toyoshim/iona/(threads)

Thread 1 (2019-07-02):

[Example] iona compatibility

toyoshim, 2019-07-02:
It worked with naomi - Ikaruga.

toyoshim, 2019-07-02:
If working titles are reported like this, I will update the Wiki's Compatibility Information.
https://github.com/toyoshim/iona/wiki/Compatibility-Information

If something is wrong, I will try getting the PCB and supporting it.

toyoshim, 2019-07-02:
Example for Japanese
日本語でもOK

naomi - 斑鳩 動作 - 動作

などと報告があれば、Wikiの情報を更新します。
動作しない報告も歓迎。基板を入手でき次第、対応を試みます。

hnakai0909, 2019-07-03:
System12 - Paca Paca Passion (PPP1) - 動作
System12 - Paca Paca Passion Special (PSP1) - 動作

なお, jvsioサブモジュール部分については,
独自のProMicro向け[移植](https://github.com/toyoshim/jvsio/pull/1/commits/ff60f7e06fa0ab4b34fd992d0e49b8fec4afaa13)を適用したものによる動作報告です.

toyoshim, 2019-07-03:
English:
Reflect https://github.com/toyoshim/iona/issues/1#issuecomment-507971420 to [Compatibility Information](https://github.com/toyoshim/iona/wiki/Compatibility-Information)

It's fine to append new report here, or you can file a separate issue so that I can close it after reflecting the report.

Japanese:
https://github.com/toyoshim/iona/issues/1#issuecomment-507971420 を[Compatibility Information](https://github.com/toyoshim/iona/wiki/Compatibility-Information)に反映させました。

ここに書いてもらっても良いし、別途issueを立ててもらってもOKです。別issueの場合は反映させたらcloseでお知らせします。

cyllboy, 2020-08-08:
Naomi 2 - Virtua Tennis (Power Smash) works flawless.

toyoshim, 2020-08-08:
Thanks! Now the Virtua Tennis is in the list!

cyllboy, 2020-08-16:
Naomi 2/Atomis wave patched - Fists of the North Star. SW Standard.
Naomi2 - Capcom_vs_SNK_Millenium_Fight_2000_Pro. SW Standard - (only 4 buttons?)

toyoshim, 2020-08-16:
Added.
I changed the system board for Virtua Tennis and new two to "naomi" rather than "naomi2" as these titles work on naomi1 too.

Regarding the 2000 pro, it seems to use only 4 buttons if [information at wikipedia](https://ja.wikipedia.org/wiki/%E3%82%AB%E3%83%97%E3%82%B3%E3%83%B3_%E3%83%90%E3%83%BC%E3%82%B5%E3%82%B9_%E3%82%A8%E3%82%B9%E3%83%BB%E3%82%A8%E3%83%8C%E3%83%BB%E3%82%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) is correct.

cyllboy, 2020-08-16:
Very good! Thank you! They are Naomi native, apart from Fists of North Star that is patched for Naomi (Atomis Wave native)

cyllboy, 2020-08-16:
Naomi - Kuru Kuru chameleon. SW Standard.
Naomi - Mobile Suit Gundam - Federation Vs Zeon. SW Standard.
Naomi - Project Justice - Rival School 2. SW Standard.
Naomi 2 - Beach Spikers. SW Standard.

toyoshim, 2020-08-25:
Information above should be seen in the compatibility page now.
Thanks a lot!

cyllboy, 2020-08-25:
> Information above should be seen in the compatibility page now.
> Thanks a lot!

It's a pleasure!

Thread 2 (2019-07-17):

Coin credits decrease at 30 credits/sec on using it with TAITO Type X2

toyoshim, 2019-07-17:
When I use iona with TAITO Type X2, coin counter continues to decrease at 30 credits/sec speed.
Probably something is wrong on command 0x30 or 0x35.

Other functionalities work well.

toyoshim, 2019-07-21:
Coin unit number should start with 1 rather than 0.
This bug results in that X2 continues to ask decreasing the credit count at every frame, since X2 manages JVS's credit to be always 0.

Closed 2019-07-21.

Thread 4 (2019-10-22):

two player

itslemcy, 2019-10-22:
hi, great work first of all.
i was wondering if it is possible with an arduino with a lot of gpios such as the mega2650, to have a two player input.
thanks a lot!

toyoshim, 2020-08-08:
sorry for the late answer.
yep, the sample code includes mega2560 support and I think it works with 2P support though I haven't verified on the real board yet.
just fyi, the underlying library, jvsio now supports multiple nodes within a single microcontroller. that says now it's possible to support 2 nodes x 2 players = 4 players in total if gpio allows. of course, 1 node x 4 players configuration would be possible.

Closed 2020-08-08.

Thread 5 (2020-06-29):

ringedge support

mikebrandt, 2020-06-29:
HI,thanks for this great project! I made myself a board using a nano and it doesn't seem to be recognized by ringedge system. I did trick the id as i know ringedge is only type 3 IO compatible but it doesn't seem to do the job. Is the actual code missing something for type 3 IO operations?

Best Regards,
Mike

toyoshim, 2020-06-29:
As far as I tried, it works with the most titles for RE2.
So, I believe iona should be compatible with RE1 in essential parts, and it will work with small mods.

IIRC, Sega 837-14572 is the type 3 IO board, right?

According to this wiki site,
https://wiki.arcadeotaku.com/w/JVS
It has 14 input buttons per player.

So, I guess the IONA should return 0x0D instead of 0x0C at the line 190.
https://github.com/toyoshim/iona/blob/master/iona.ino#L190

JVS titles check several JVS IO information.
# of players, # of digital buttons, and the board name are such things I confirmed until today.

mikebrandt, 2020-06-29:
thanks for your reply.  I tried to trick id with "SEGA CORPORATION;I/O BD JVS;837-14572;Ver1.00;2005/10" but it dosen't seem to work either. Maybe there's something wrong with my wiring , i didn't wired your dipswitchs ios, only data + data - ground and sense using the low filter RC trick.
data+: RX0
data-: D2
Sense: D3 via RC filter

Best regards,

toyoshim, 2020-06-29:
Hum... can you enter the RE's test mode and confirm if the iona is recognized as a JVS node?

If iona is not recognized:
Can you modify jvsio/JVSIO.cpp so that dump() do nothing? This is used to output debug messages, but it may result in timing violation on JVS transaction. Ringedge and Ringwide seem timing sensitive.

If iona is recognized:
Can you try with line 190 fix only? IONA's default name passes all known cases until today as starting with "SEGA ENTERPRISES,LTD." seems to be the key portion for some titles running on SEGA hardwares. Exact match with the original type 3 board may result in more strict information checks. Not sure, but just in case.

Also, if you don't use DIP switch, please pull-down A7, or remove DIPSW handling code from updateMode() in iona.ino. You should keep the suchipai_mode and virtual_mode to be false for usual uses.

mikebrandt, 2020-06-30:
thanks for your reply. I Applied all your recommendations at once and it works, so many thanks for this. Now i will revert it back step by step to see what was the original problem then i'll move on arduino mega tests. Is there a way to make a donation for your work on this?
Best regards

toyoshim, 2020-08-08:
thanks!
no worries, feedback is already beneficial contributions to this project!

toyoshim, 2020-08-08:
If you can provide, information for the compatibility list below can be another great contribution :)
https://github.com/toyoshim/iona/wiki/Compatibility-Information

Thread 6 (2020-07-30):

Earth of the RC-LPF

cyllboy, 2020-07-30:
I know... this is a newbie question...
Where do I connect the earth of the RC-LPF? As far as I know it is not the same as "ground".

I refer to the symbol:

   |
-----
/////

Thank you!

cyllboy, 2020-08-07:
Issue solved, I Connected it to the common ground

toyoshim, 2020-08-08:
Sorry, I haven't noticed your question.
Yes, using a common ground is fine. RC-LPF is a "kind of analog circuit", but here it is used only to generate a 2.5V signal from a 5V 1:1 PWM signal. So, we don't need to be so serious against noise.

toyoshim, 2020-08-08:
this will be a good question to be kept open for others.

cyllboy, 2020-08-08:
Thank you! Your design works like a charm!

Thread 7 (2020-08-14):

Only two buttons working

cyllboy, 2020-08-14:
I'm testing with a Naomi 2 board, I have only two buttons working. Up down left right, player 1 start and player 1 coin are ok. Only fire buttons A and B work. Checked twice the connections but are a ok and tested with multimeter.

I'm pulling down A7 with 10K ohm resistor to simulate dip switch off.

Do you have any suggestions?

toyoshim, 2020-08-14:
oops!
sorry, it seems my last commit mistakenly added a bug.

> 221:          io.pushReport(index < sizeof(index) ? ios[index] : 0x00);

This line should be

> 221:          io.pushReport(index < sizeof(ios) ? ios[index] : 0x00);

I will submit a fix soon.

toyoshim, 2020-08-14:
submitted!
can you try with the the latest revision?

sorry for bothering you.

cyllboy, 2020-08-15:
The latest version works very well! Now all the 6 buttons are ok!
Thank you very much!

toyoshim, 2020-08-15:
Good to hear that my fix works, and thanks again for letting me know this issue.

Regarding the compiler warnings, I guess you are using a little old Arduino IDE.
With my 1.8.12 on mac, iona compiles without any warning. Maybe due to no or poor C++11 support in early Arduino IDE?

cyllboy, 2020-08-16:
I had 1.8.12 but I'm using windows; now I updated to 1.8.13, but  warnigs did not go away.

At first installation, the warnings are covered by the code windows... and I didn't see them in windows because the lasting message was the OK thing: "Lo sketch usa 5306 byte (17%) dello spazio disponibile per i programmi. Il massimo è 30720 byte.
Le variabili globali usano 1030 byte (50%) di memoria dinamica, lasciando altri 1018 byte liberi per le variabili locali. Il massimo è 2048 byte." (My installation is Italian)

Did you tried to enlarge the debug portion of the window?

Here is what I see: https://www.cyllenius.net/Screenshot%202020-08-16%2009.53.03.png

Then I opened better the window and I could see that the warnings were still there. They are these:
"
H:\Desktop\iona\iona.ino: In function 'setup':
H:\Desktop\iona\iona.ino:142:19: warning: iteration 15 invokes undefined behavior [-Waggressive-loop-optimizations]
     pinMode(pins[i], INPUT_PULLUP);
             ~~~~~~^
H:\Desktop\iona\iona.ino:141:21: note: within this loop
   for (int i = 0; i < sizeof(pins); ++i)
                   ~~^~~~~~~~~
C:\Program Files (x86)\Arduino\hardware\arduino\avr\cores\arduino\main.cpp: In function 'main':
H:\Desktop\iona\iona.ino:142:19: warning: iteration 15 invokes undefined behavior [-Waggressive-loop-optimizations]
     pinMode(pins[i], INPUT_PULLUP);
                   ^
H:\Desktop\iona\iona.ino:141:21: note: within this loop
   for (int i = 0; i < sizeof(pins); ++i)
"

I don't know if this is a problem with my current computer where I installed in the time various versions of the IDE... I will try on a fresh computer that never had Arduino IDE on and I will report better.

cyllboy, 2020-08-16:
I confirm the same behaviour on a fresh laptop... The warings are generated, than they "roll out of sight" during compilation.

Probably the C++ support is very weak in windows version.

The warnigs go away if the loop is not used, but so the code should be taylored on the number of pin used on the specific device, leaving less freedom. What do you think?

toyoshim, 2020-08-16:
oops, compiler is correct. there is a buffer-overflow bug.
the loop should be "i < sizeof(pins) / sizeof(int)".

I'm on mac. probably installed AVR compiler version is different among Windows and mac.

I'll update it.

toyoshim, 2020-08-16:
done!

cyllboy, 2020-08-16:
Y*O*U* A*R*E* G*R*E*A*T*!!!!!!!!!!!!!!!!!!!!!!! =b

Closed 2020-08-15.

Thread 10 (2020-11-14):

About MegaClient Sense port

xxjerryxx1983, 2020-11-14:
FIrst of all, thank you for bring us such nice program, I really appreciate it.
I'm wondering if that the JVS sense port in ArduinoMega client is correct, because the OC2B port on board is D9, not D3 port mentioned in file, and neither 2 ports are not effective for the game.
The "JVS connect error" will happen when I enter the TTX game(SF4 AE, KOF98Um), please tell me the correct port of the sense signal, thank you very much.

// Data+: 2 PD2 ( RXDI/INT2 )
// Data-: 3 PD3 ( TXD1/INT3 )
using MegaDataClient = BaseDataClient<0, 1, 0, 1, 0x0e, 0x0e>;

// Sense: 3 (PWM OC2B - RC LPF of 100nF, 100Ω is needed to generate 2.5V)
using MegaSenseClient = BaseSenseClient<3>;
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

toyoshim, 2020-12-09:
Thank you for your report, and sorry for the late reply.

> I'm wondering if that the JVS sense port in ArduinoMega client is correct, because the OC2B port on board is D9, not D3 port mentioned in file, and neither 2 ports are not effective for the game.

> // Sense: 3 (PWM OC2B - RC LPF of 100nF, 100Ω is needed to generate 2.5V)
> using MegaSenseClient = BaseSenseClient<3>;

You are right. It's a bug. We should use D9 for the SENSE port. So, the using line should be BaseSenseClient<9>;.
Also, the D9 is used for 1P button2 by default in the IONA. So, we need to replace it with another available pin.

I will submit a speculative fix for this though I'm not ready for testing this on mega2560.

toyoshim, 2020-12-09:
Can you check the latest revision?
I fixed the jvsio library to use pin9 for sense on mega.
Also, pin assignment for the mega is changed in iona.ino.

Closed 2020-12-09.

Thread 12 (2021-02-15):

Service button

kimaq, 2021-02-15:
Hi,

I'm testing your project on Arduino Nano. It's working great but as I can see for this board there's no Service button handling.
I'll switch to Mega if needed but is it possible to do it on Nano?

  //       START       SERVICE     UP          DOWN        LEFT        RIGHT       PUSH1       PUSH2
    ios[1] = in( 2, 7)    ???    | in( 3, 5) | in( 4, 4) | in( 5, 3) | in( 6, 2) | in( 7, 1) | in( 8, 0);

Kind Regards,
Peter

toyoshim, 2021-02-27:
Well, A4 and A5 are still free on the nano.
So, you can put one of them into pins[] array, and use the IO for the service button.

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

'in(13, 6)' should be inserted for ios[1]. '13' means the A4 is placed at 13th (0 origin) in the pins. '6' means service button here.

> ios[1] = in( 2, 7) | in(13, 6) | in( 3, 5) | in( 4, 4) | in( 5, 3) | in( 6, 2) | in( 7, 1) | in( 8, 0);

I haven't verified these code, but probably it works.

kimaq, 2021-02-27:
Thanks,
It's working now. But now as I can access input test mode I noticed that some inputs are triggering another inputs.
For example holding SW1 I get solid "ON" on JVS test screen.
But holding SW3 I get constantly ON/OFF for SW3 and for SW2 as well. It's the same for most other inputs.
Do you know what can be wrong? I've checked the wiring and it looks good. My nano is a clone, maybe that is a problem?

toyoshim, 2021-02-28:
Did you edit following lines correctly?
> //#define USE_NANO
> #define USE_MEGA

Default code isn't for Nano, but for MEGA2560.

Also, can you check if the unstable input issue disappears when you remove updateMode() call at line 166?

kimaq, 2021-02-28:
Thanks again,

removing updateMode() solved the issue:) I can finally play my Naomi outside the cabinet.

Closed 2021-02-28.

Thread 13 (2021-11-13):

missing push button 2 for two player mode on Mega

mikebrandt, 2021-11-13:
Hi,
 i tried to compile iona for Mega and i think that push button 2 for player 2 is missing in io def at line 117. Am i reading code wrong?

Best regards,
Mike

toyoshim, 2021-11-14:
I guess you meant line 177.
This is just a source formatting issue. The service button isn't assigned for the player 2 (as same as player 1), and it results in that we have just 7 `in(n, m)` in the line. So, that should be fine.
I will submit a format fix change.

toyoshim, 2021-11-14:
https://github.com/toyoshim/iona/commit/65986f8bb2548e6de19828708844f9878198d156
Hope this CL explains better than my words above.

Closed 2021-11-14.

Thread 14 (2021-11-14):

Missconfiguration on Mega Client definition?

mikebrandt, 2021-11-14:
Hi,
   tried to make iona work for Mega 2560 and i think there's a missconfiguration on MegaClient:
// Data+: 2 PD2 ( RXDI/INT2 )
// Data-: 3 PD3 ( TXD1/INT3 )
using MegaDataClient = BaseDataClient<0, 1, 0, 1, 0x0e, 0x0e>;

In that setting , Data + seems to be assigned to PD0 and Data - to PD1.
Am I reading it wrong?

Best regards,
 Mike

toyoshim, 2021-11-14:
Thank you for your feedback.
I actually provided the Mega Client, but I haven't gotten a chance to verify my code with a device.
So, there would be some bugs.

Regarding the MegaDataClient, I think the comment was wrong.
Maybe I copied it from another port, and just forgot to modify the comment.
Let me have a fix.

toyoshim, 2021-11-14:
Can you try the latest version?
Now the comment was fixed. We use D0/D1 (== PE0/PE1 or RX0/TX0) for Data+/Data-.
Also, I notice that P2 button 5 and 6 were mistakenly assigned to non-existing GPIO pins.
So, I changed it to use D2 and D3.

Please let me know if something is still wrong.
Thanks!

mikebrandt, 2021-11-15:
Hi,
 just tried it with last version , wired data + on D0 and data - on D1 (sense still on D9). No input is sent to the mobo (TTX3) while it works great with nano version. Are you sure about register adress on Mega Client?  those values shouldn't be different between nano and Mega . From what i understand, it should be 0x0b according to documentation.
Best regards,
Mike

mikebrandt, 2021-11-18:
Hi, i think you're right:
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
so problem must be elsewhere, i'll try to serial debug it to see what's going on.

Thread 15 (2021-12-10):

NanoSenseClientSupportingDaisyChain broken?

mikebrandt, 2021-12-10:
Hi,
 i tried to link 2 nano to enable multiple nodes . I replaced NanoSenseClient  NanoSenseClientSupportingDaisyChain in main code this way:
`#if defined(USE_NANO)
NanoDataClient data;
NanoSenseClientSupportingDaisyChain sense; //using daisyChain sense client
//NanoSenseClient sense; //original
NanoLedClient led;`

when compiling it comes with this error:
`In file included from C:\ionav2\iona\jvsio\clients\NanoClient.h:12:0,
                 from C:\ionav2\iona\iona.ino:10:
C:\ionav2\iona\jvsio\clients\BaseClient.h: In instantiation of 'void BaseSenseClientSupportingDaisyChain<PORT, TCCRA_VAL, TCCRA_FLIP, OCRA_VAL, SENSE>::begin() [with int PORT = 3; int TCCRA_VAL = 18; int TCCRA_FLIP = 16; int OCRA_VAL = 1; int SENSE = 19]':
C:\arduino_projects\iona\iona.ino:271:1:   required from here
C:\arduino_projects\iona\jvsio\clients\BaseClient.h:144:66: error: 'void BaseSenseClient<PORT, TCCRA_VAL, TCCRA_FLIP, OCRA_VAL>::begin() [with int PORT = 3; int TCCRA_VAL = 18; int TCCRA_FLIP = 16; int OCRA_VAL = 1]' is private within this context
     BaseSenseClient<PORT, TCCRA_VAL, TCCRA_FLIP, OCRA_VAL>::begin();
     ~~~~~~~~~~~~~~~~~~~~~~~~~~~~~~~~~~~~~~~~~~~~~~~~~~~~~~~~~~~~~^~
C:\arduino_projects\iona\jvsio\clients\BaseClient.h:114:8: note: declared private here
   void begin() override {
        ^~~~~
exit status 1
`

Am I doing it wrong or is the code broken?

Best regards,
Mike

mikebrandt, 2021-12-16:
Ok, found what was broken since begin method was declared private into BaseSenseClient , it couldn't be used by DaisyChain client,  changed it t protected solved the problem.
`template <int PORT, int TCCRA_VAL, int TCCRA_FLIP, int OCRA_VAL>
class BaseSenseClient : public JVSIO::SenseClient {
 protected: //former private
  void begin() override {`

Now i need to test node linking. I'll keep you updated with this!

mikebrandt, 2021-12-17:
Just did some tests with two board linked on TTX3. First board in the chain isn't recognized and second is seen as 1 player but controls work . Any idea on how this could happen? Or any adivse on how to test nodes?
Best regards,

Thread 16 (2022-05-05):

Naomi detection issues

system11b, 2022-05-05:
I have a V2 Iona which was only recently purchased and I believe has 1.3x firmware installed.  It works with Ringedge2 and Exa systems, but my Naomi 1 doesn't recognise it - the blue LED never stops flashing, test mode cannot see any JVS nodes, and starting a game gives JVS IO not connected errors.  I have tried multiple USB(JVS) and power cables right down to the shortest available - these did not make a difference.  The Naomi works fine with Capcom and Sega JAMMA-JVS converters so I assume it is working correctly.

There are a few people with the same issue on the arcade projects forum:
https://www.arcade-projects.com/threads/mp07-iona-us-jvs-usb-i-o-board-worldwide-sales-troubleshooting-thread.20112/page-11

system11b, 2022-05-05:
I solved the problem, kind of.

I had to upgrade the firmware from 1.35 to 1.42d, even after upgrade it was not detected until I used the new options mode to inactivate the JVS signal adjustment.  I have a question - what does this option actually do?  Will it potentially cause harm to other hardware (for example my Exa) by sending a high signal, or is it the other way around and disabling a boost?  I repeated the test several times, with the signal adjustment enabled (default dip 3) it always fails, with dip 3 on to disable adjustment it is reliable both in BIOS and Game modes.

I also had a problem with WinUSB and getting "This device cannot start. (Code 10)" when trying to install the WinUSB driver.
I did a bunch of testing, it's simply not compatible with some USB ports. It doesn't work on the built in USB-A (3.1) ports on my Lenovo X1 gen 4, but it's fine with a couple of cheap unpowered USB-C hubs/adapters - for example the Unigreen USB-C to Ethernet dongle which has 3x USB-A (3.1) ports. That works perfectly.

mobiusstriptech, 2022-05-20:
Same issue here. Worked just fine on both my NAOMI 2 but neither of my NAOMI 1 would work with the device. I ended up doing the same thing you did and upgrading the firmware, then disabling the JVS signal adjustment. For those with Xbox controllers button 3 is B, just to help you figure that out.

I wish there was an easier way to disable/enable this. Figuring out how to get to the options menu is tricky. Once I figured out that I had to hold test and service for .5 seconds, then press service, then press test 2 times, then hold down B on my controller when pressing test again for the 3rd time, it worked great. Hope that explanation helps others.

Could we have this option disabled by default? Or maybe hold test on power on to enable/disable?

toyoshim, 2022-05-22:
Hi, this is a repository for an Adruino-based IONA, and what you are talking about is IONA-US, and the repository is https://github.com/toyoshim/iona-us/issues

toyoshim, 2022-05-22:
Reg the signal adjustment option, it doesn't affect sending signals, but affects receiving ones as some device's neg signal is really higher, e.g. 1.7V, than the threshold for the 3.3V based IONA's microcontroller. So this is an option to activate voltage divider for receiving signals.

This compatibility troubles happen because IONA-US could not cover all possible valid range of EIA-RS485 but signal's characteristics vary board by board.

toyoshim, 2022-05-22:
Also, the signal compatibility issue is explained in the official document at the compatibility section.
https://toyoshim.github.io/iona-us/en

Your experience around WinUSB's trouble shooting would be helpful for other users. I'll update the page with your information.

toyoshim, 2022-05-22:
To mobiusstriptech:
Having another easy option to flip the mode sounds a good idea. But I don't want to change the default mode as more devices are compatible with this flag being enabled.

toyoshim, 2022-05-23:
Let me close this thread as this issue doesn't happen on Arduino based IONA as AVR runs at 5V.
Feel free to open new issue for iona-us.

toyoshim, 2022-05-28:
@mobiusstriptech please check the latest firmware as it contains the feature you requested, booting with TEST pressed will flip the signal adjust option.

mobiusstriptech, 2022-05-28:
Loaded the new firmware and tested using Test button to flip the JVS signal off and on. It works great! Excellent addition to the firmware!
