toyoshim/iona/(commit log)

2018-02-11 Update README.md
    Fix broken layout of schematic.
2018-02-21 coint counter bug fix
    [iona.ino]
2018-02-22 Su Chi Pai III mode
    Maybe Naomi's common protocol to support mahjong controllers.
    JVS 3 defines an input swith layout for mahjong games, but
    Su Chi Pai use a different protocol, probably because the spec
    hasn't defined yet when the game is launched.
    It uses general purpose output driver to select a input switches
    set to multiplex input switches in the first line .
2018-03-09 Support more naomi games
    To support more naomi games,
    - Use SEGA compatible names for the board ID
    - Change capability to say supporting two players (just saying)
    - Ditto, supporting analog inputs
2018-09-04 Add Virtual-On mode
    Implement Virtual-On mode that emulates the twin stick controller
    by single arcade controller that has only one 1 stick and 4 buttons.
    The arcade stick affects both left and right sticks, but if button 2
    is pressed, right results in turning left, left does turning right,
    up does jumping, and down does cancelling it. Button 1 is L shot,
    button 4 is R shot, and button 3 is turbo for both L and R.
    Not sure if this is the best assignments, but it works enough.
    Suggestion is welcomed, but definitely using SS twin stick is the
    best alternative way to play Virtual-On.
2018-11-21 Update README.md
    5V from JAMMA should be provided via Nano 5V pin.
    VIN needs 7+V for driving regulator to generate expected 5V.
    Probably, JAMMA's 12V may work with VIN, but I haven't tried.
2019-06-09 Bug fix
    - Roll the latest jvsio that fixed bugs
    - Update .ino so to follow the new interface
    Following revisions after recent JVSIO rools haven't worked.
    - 79592a636e6a663a153fc996fef43db999d215f2
    - 228c5826017673b9b91f06f56172fd73c64edcdd
    - 4b75ca0874f5b624ef2a536449ba0e3bdd572fe7
    [iona.ino]
2019-07-31 CoinSub bug fix: Unit ID should start from 0
    [iona.ino]
2019-10-29 Update credit handling to support more titles
    - Some titles call kCmdIoId on each frame, and it resets the credit
    in the previous code. It should be reset on kCmdReset.
    - Some titles call kCmdCoinSub with a zero origin index, though the
    spec requires it starts with 1. So, we do not check the index to
    support both cases in an easy way.
    [iona.ino]
2019-10-30 It seems some unofficial title expect the function reports are placed in a specific order, such as sw input comes first, then coin input follows, etc.
    Such titles compile a command series to query inputs
    as in the same order as it they appear in the report,
    then fail to parse the coin input coming later.
    [iona.ino]
2020-01-17 Bug fix for SUPPORT_2P
    [iona.ino]
2020-01-17 Another fix to support 2P, sending back input data correctly
    [iona.ino]
2020-08-14 Fix a regression bug introduced in the last submit
    This change fixes the issue 7.
    [iona.ino]
2020-08-16 fix a buffer overrun issue
    [iona.ino]
2020-12-09 Bug fix and refactoring to support Arduino MEGA correctly
    There is a bug that a wrong pin is assigned for the JVS sense
    on Arduino MEGA. The bug was fixed in jvsio library, and this
    commit contains the jvsio library roll, and iona.ino side fix
    to avoid using the conflicted pin for the SENSE.
    As clean-up, this patch move the pins array to the global space
    and use the definition to scan button inputs.
    Warning: this revision hasn't well verified.
    See also https://github.com/toyoshim/iona/issues/10
    [iona.ino]
2021-11-14 Format fix for player 2's first data
    [iona.ino]
2021-11-14 Fix mega2560 2 player support
    - use D2 and D3 instead of D22 and D23 that don't actually exist.
    [iona.ino]
